JanLelko/presence_radar/docs/raport/strona_tytulowa.pdf

| Katedra Grafiki Wizji Komputerowej i Systemów Cyfrowych | RAu6
Rok akademicki: | Rodzaj studiów*: SSI/NSI/NSM | Przedmiot (Języki Asemblerowe/SMiW): | Grupa | Sekcja
2025/2026 | TI | SMIW | 3
Imię: | JAN | Prowadzący: OA/JP/KT/GD/GB/KH/ AO | JP
Nazwisko: | LELKO

# Report

Temat projektu:

## System monitorowania obecności człowieka

Główne założenia projektu:

Cel układu:
Bezkontaktowe monitorowanie obecności człowieka w wyznaczonej strefie. Urządzenie ma za zadanie analizę otoczenia i automatyczne reagowanie (np. generowanie alarmu) w przypadku zmiany statusu monitorowanego obiektu. Zasilanie:
Układ będzie zasilany z zewnętrznego zasilacza sieciowego o napięciu 5V.

## Data oddania: dd/mm/rrrr

09.09.2026
