JanLelko/presence_radar/hardware/radar_xm125_esp32c6/radar_xm125_esp32c6.kicad_pcb

## KiCad design hardware/radar_xm125_esp32c6/radar_xm125_esp32c6.kicad_pcb (2026-11-01)

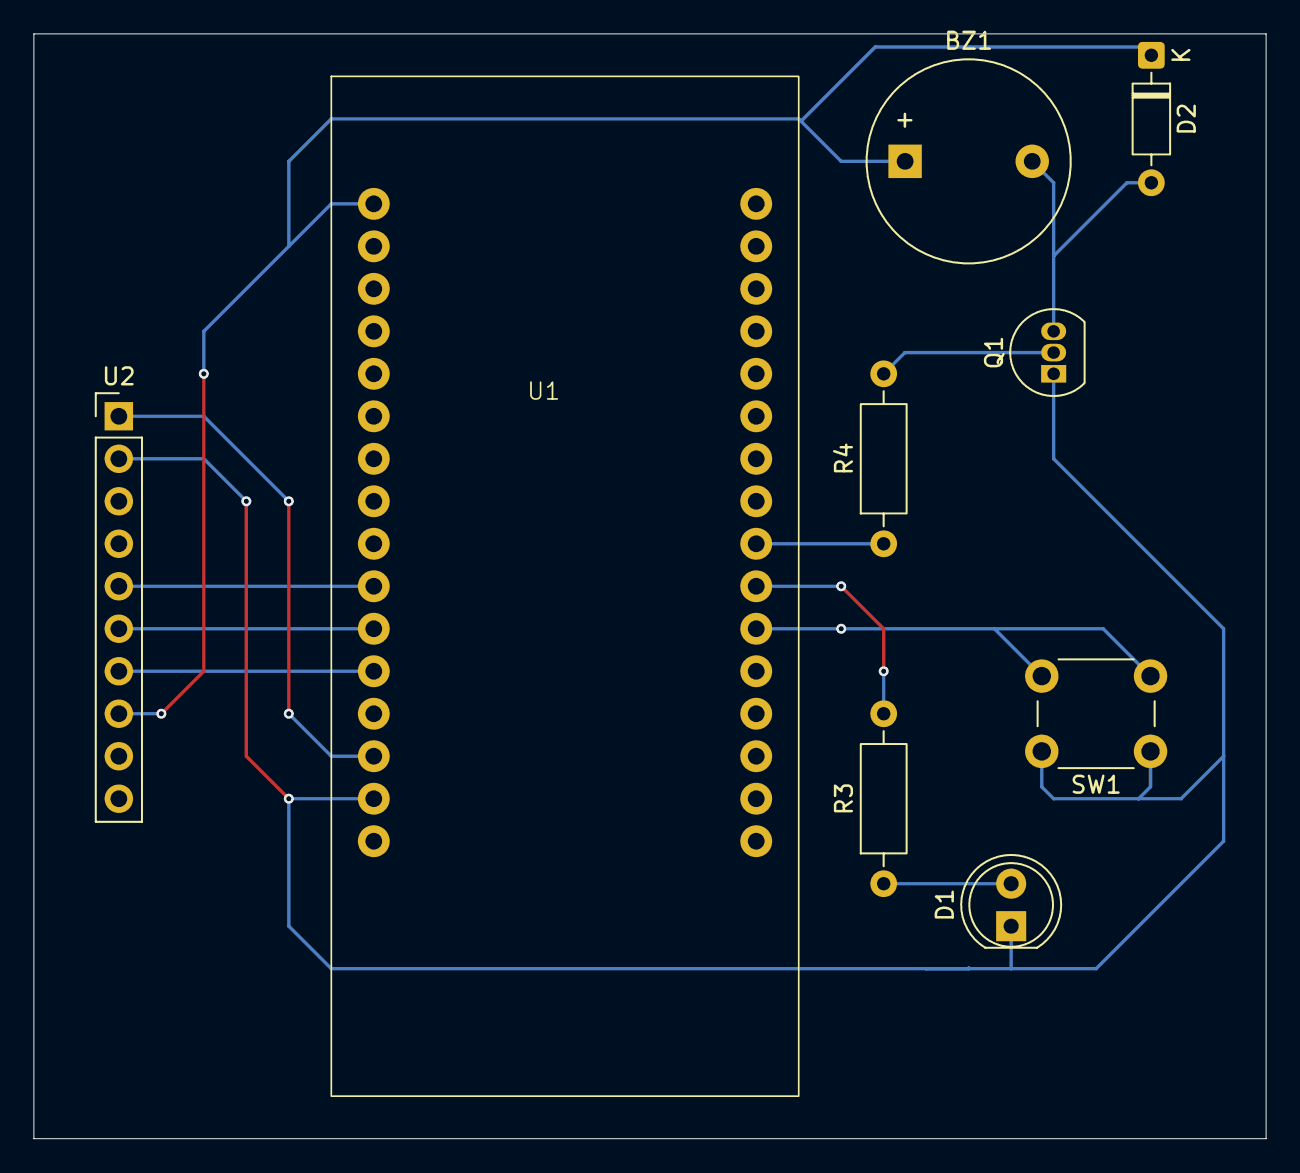
[picture p9: board radar_xm125_esp32c6.kicad_pcb from above]

Board: 2 copper layers, 73.7 x 66.0 mm, 9 parts (0 on the bottom side), 12 nets.

Parts:
BZ1: Buzzer; Buzzer_12x9.5RM7.6
D1: LED; LED_D5.0mm
D2: 1N4148; D_DO-35_SOD27_P7.62mm_Horizontal
Q1: 2N2222A331; TO-92_Inline
R3: 330; R_Axial_DIN0207_L6.3mm_D2.5mm_P10.16mm_Horizontal
R4: 1k; R_Axial_DIN0207_L6.3mm_D2.5mm_P10.16mm_Horizontal
SW1: SW_Push; SW_PUSH_6mm_H5mm
U1: ESP32_C6_WROOM_1_DEV; ESP32_C6_Devkit
U2: Waveshare_A121_Radar; PinHeader_1x10_P2.54mm_Vertical

Connections:
+3.3V: BZ1.1 (+), D2.1 (K), U1.1 (3V3), U2.8 (WAKE_UP)
+5V: U1.14 (5V), U2.1 (5V)
/BUTTON: SW1.2, U1.27 (GPIO9)
/BUZZER: R4.1, U1.25 (GPIO19)
/LED_STATUS: R3.2, U1.26 (GPIO18)
/MCU_INT: U1.12 (GPIO2), U2.7 (MCU_INT)
/SCL: U1.11 (GPIO11), U2.6 (SCL)
/SDA: U1.10 (GPIO10), U2.5 (SDA)
GND: D1.1 (K), Q1.1 (E), SW1.1, U1.15 (GND), U2.2 (GND)
unnamed: BZ1.2 (-), D2.2 (A), Q1.3 (C)
unnamed: D1.2 (A), R3.1
unnamed: Q1.2 (B), R4.2
