JanLelko/presence_radar/(commit log)

2026-05-12 Initial commit: ESP32-C6 I2C driver for Acconeer XM125 presence radar
2026-05-21 refactor: split firmware into components, add KiCad hardware project
    [radar_xm125_esp32c6.kicad_pcb, radar_xm125_esp32c6.kicad_sch]
2026-06-08 feat: Wi-Fi provisioning via captive portal
    Szczegóły poprawek:
    - Dodano obsługę dekodowania URL dla znaków specjalnych w adresie MQTT.
    - Zoptymalizowano funkcję load_credentials z bezpiecznym odczytem pamięci NVS.
    - Usunięto błędy multiple definition dla zmiennej mqtt_client.
    - Zablokowano próbę łączenia z Wi-Fi przy pustym haśle (puste ciągi w NVS).
    [radar_xm125_esp32c6.kicad_pcb, radar_xm125_esp32c6.kicad_sch]
2026-06-25 feat: DNS-based captive portal auto-popup and docs update
    [radar_xm125_esp32c6.kicad_pcb, radar_xm125_esp32c6.kicad_sch]
2026-06-26 feat: reset stored config with BOOT button and return to captive portal
    Przytrzymanie przycisku (GPIO9) ~3 s kasuje zapisana siec/MQTT z NVS
    i restartuje urzadzenie do captive portala (3x sygnal buzzer+dioda).
    Usunieto martwa, niezarejestrowana funkcje wifi_event_handler.
    [main.c]
2026-06-26 feat(dashboard): alarm switch and connection-loss detection
    Switch 'Alarm' w panelu: gdy uzbrojony i brak obecnosci pod czujnikiem
    -> dzwiek (Web Audio) + czerwony baner. Watchdog oznacza karty jako
    OFFLINE przy braku danych >10 s lub padzie brokera; przy uzbrojonym
    alarmie utrata lacznosci wyje tak samo jak brak obecnosci.
2026-06-26 chore: ignore KiCad artifacts and untrack them
    Autosave, backupy (*-backups/), fp-info-cache, locki, *.bak,
    *.kicad_sch-bak oraz *.kicad_prl przestaja byc wersjonowane.
    Pliki pozostaja na dysku (git rm --cached). W repo zostaje realny
    projekt: .kicad_pcb/.sch/.pro/.sym + tabele bibliotek + footprint.
2026-06-29 feat: LED synchronization, dashboard improvements and RGB status signalling
    Firmware:
    - status_led.c przejmuje diode na PCB (GPIO18) i miga nia w lockstep z
    wbudowanym RGB (GPIO8) - ta sama czestotliwosc i faza; w main.c zostal
    tylko buzzer. Pin oddawany przy wyjsciu z alarmu i przed sygnalem resetu.
    - MAX_TEMP obnizone 60 -> 20 (prog POZARU wyzwalany chuchnieciem, demo).
    Dashboard:
    - przy czujniku offline wykres jedzie dalej na 0 (watchdog dopisuje zera),
    zamiast zamarzac.
    - godzina na wykresie i w logach w formacie 24h (timeLabel, pl-PL).
    - chowane mini-wykresy temperatury i dystansu (osobne skale, przycisk).
    Plus wczesniejsza, niescommitowana praca: modul status_led, flagi stanu
    i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
    [radar_xm125_esp32c6.kicad_sch]
2026-09-02 refactor: make radar.c the sole I2C owner, add board_pins.h
    Przygotowanie pod konfiguracje radaru z panelu. Zmiana bez wplywu na
    dzialanie - logika alarmow, format JSON i takt petli nietkniete.
    - main/board_pins.h (nowy): wszystkie piny GPIO w jednym miejscu.
    Wczesniej rozjazd SDA=GPIO2 (main.c) vs SDA=GPIO10 (martwy radar.c,
    a GPIO10 to linia INT radaru).
    - main/radar.c przepisany: przejmuje cala magistrale I2C0, poprawne
    piny z board_pins.h. API: radar_init / radar_bringup_blind /
    radar_read_frame. Dekoduje juz detector_error (bit15), nieuzywany do fazy 1b.
    - main/radar.h: radar_frame_t zamiast radar_data_t; komentarze
    intra = ruch szybki, inter = ruch wolny.
    - main/main.c: -56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
2026-09-02 refactor: radar bring-up with detector status readback
    Zamiast slepego "APPLY + delay(500) + START" — sekwencja z weryfikacja,
    ktora OSTRZEGA w logu, ale nie brickuje (swiadomie: ostrzejszy bring-up
    odmawiajacy tam gdzie slepy dzialal zabilby dzialajace demo).
    - radar_bringup() zastepuje radar_bringup_blind():
    * czyta REG_VERSION (0x0000) — same zera => log "WAKE_UP wisi?"
    * APPLY_CONFIGURATION -> poll BUSY (bit31 statusu 0x0003), timeout 3s
    * START_DETECTOR -> poll BUSY, timeout 2s
    * ocena maski *_OK (bity 0..7) i *_ERROR (16..23, 28) — log ERROR/WARN/OK
    * Measure Counter (0x0002) czytany 2x co 500 ms — czy detektor faktycznie liczy
    - radar_read_u32() + radar_wait_not_bus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
    [main.c, radar.c, radar.h]
2026-09-02 feat: radar config model, write-all and application state machine
    Fundament pod strojenie radaru z panelu. Bez sieci i NVS — konfiguracja
    sterowana presetem wkompilowanym; fazy 3-4 dorzuca MQTT/NVS/progi edge.
    radar_cfg.{h,c} — model danych:
    - radar_cfg_t: 24 zapisywalne rejestry detektora (0x0040..0x0080) jako u32.
    - RADAR_CFG_DESC[]: tabela deskryptorow (klucz JSON, adres, offset, min/max,
    default, is_bool) — JEDNO zrodlo prawdy dla clamp / write-all / (faza 3)
    parsera JSON.
    - _Static_assert x2: pole w strukturze bez wiersza w tabeli = blad kompilacji.
    Wymog przez semantyke write-all: RESET_MODULE cofa modul do POR, wiec kazda
    rekonfiguracja musi przepisac CALY zestaw, nie t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
    [main.c, radar.c, radar.h, radar_cfg.c, radar_cfg.h]
2026-09-02 fix: address review findings in config model and bring-up
    Recenzja (osobny agent, zakres 87c1872..HEAD). Bledy poprawnosciowe:
    - radar_wait_not_busy(): blad odczytu statusu (NAK, gdy STM32 kalibruje po
    APPLY) byl zwracany natychmiast -> radar_apply_and_start konczyl przed
    START, mimo deklaracji "i tak konczy w STARCIE". Teraz blad odczytu = "wciaz
    BUSY", petla do tmo_ms; zwraca tylko ESP_OK / ESP_ERR_TIMEOUT. Martwe galezie
    bledu w radar_apply_and_start usuniete.
    - radar_apply_config(): brak zwloki po RESET_MODULE -> pierwszy odczyt
    VERSION/STATUS mogl trafic w STARA instancje firmware (wyglada jak boot OK),
    a write-all lecial w wyscig z resetem. Dodane RESET_SETTLE_MS=100 ms +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
    [main.c, radar.c, radar.h, radar_cfg.c]
2026-09-03 feat: radar configuration from the dashboard over MQTT
    Temat pokoj/101/cfg (retained, panel->radar) przyjmuje plaski JSON z deltami
    configu; radar aplikuje je pelnym RESET_MODULE + write-all + APPLY + START +
    weryfikacja (blokujace, ~0.7 s) i publikuje retained snapshot na
    pokoj/101/cfg/state. Trwalosc w NVS (blob magic+wersja+CRC32, klucz cfg_v1),
    wczytywany przy boocie zamiast wkompilowanego presetu.
    - radar_cfg.c: reczny parser/serializer JSON (IDF v6.1 nie ma cJSON; payload
    jest plaski, skan po kluczach z RADAR_CFG_DESC), radar_cfg_load/save (NVS).
    - wifi_mqtt.c: kolejka mqtt_cmd_queue (glab. 4, by-value) — task MQTT tylko
    kopiuje, petla radaru konsumuje; subskrypcja pokoj/101/cfg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
    [main.c, radar_cfg.c, radar_cfg.h, wifi_mqtt.c, wifi_mqtt.h]
2026-09-03 feat: edge-logic thresholds configurable from the dashboard
    edge_cfg.c/.h: PODLOGA_MM / PROG_UPADKU / MAX_TEMP + nowe zasiedzenie_s jako
    edge_cfg_t, sterowane tym samym tematem pokoj/101/cfg pod kluczem "edge":{}.
    Ten sam wzorzec co radar_cfg: tabela deskryptorow, _Static_assert, clamp,
    sanitize, wlasny blob NVS (edge_v1). cfg/state ma teraz obiekt "edge":{} obok
    "radar":{}. Zmiana edge nie dotyka I2C — natychmiastowa. Licznik ZASIEDZENIA
    przeliczony z zaszytych "1200 petli" na zasiedzenie_s * 1000 / LOOP_PERIOD_MS.
    cmd: {"armed":...} zostaje parsowane natychmiast w handlerze MQTT (nie przez
    kolejke cfg — blokujacy apply moglby opoznic rozbrojenie alarmu), ale przez
    cfg_json_u32(buf,"ar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
2026-11-01 docs: add final report, update TODO and radar parameters
    [radar_xm125_esp32c6.kicad_pcb]
2026-11-01 feat: add XM125 STM32 firmware binary and Acconeer license
2026-11-01 docs: stack panel and device photos vertically
2026-11-10 build: track sdkconfig.defaults instead of generated sdkconfig
    sdkconfig and sdkconfig.old are generated by ESP-IDF and no longer versioned.
2026-11-10 build: rename CMake project from i2c_check to presence_radar
